Bedrelyer/Air-Suction-Demonstration-Device/(list of files, cad)

Other CAD files:
恒河战舰组说明+简图/原理方案简图v3.dwg
