Bedrelyer/Air-Suction-Demonstration-Device/091010163644_0轴系装配图/091010163644_0轴系装配图_1.Jpeg

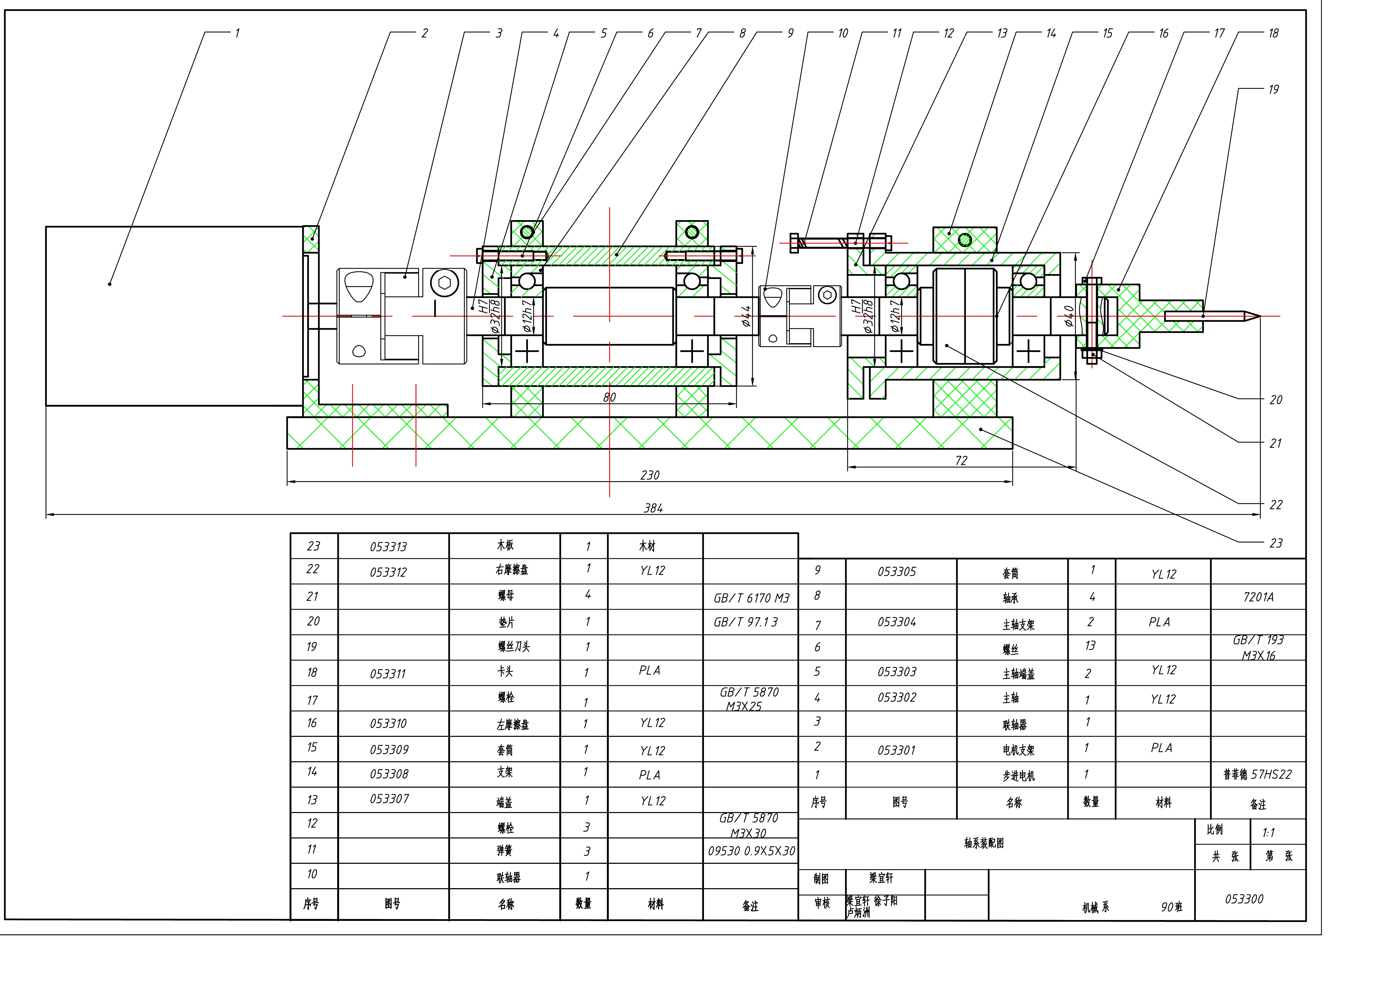
091010163644_0轴系装配图/091010163644_0轴系装配图_1.Jpeg
